VietHoang0605/OV7670_Camera_GitHub/Docs/REPORT_OV7670_CAMERA_FINAL.html

📚 Lý Thuyết & Kiến Trúc 🐛 Nhật Ký Sửa Lỗi

# BÁO CÁO KỸ THUẬT TOÀN DIỆN: DỰ ÁN HỆ THỐNG CAMERA OV7670 TRÊN FPGA

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

💡 GHI CHÚ QUAN TRỌNG: Báo cáo này tổng hợp lại toàn bộ kiến trúc hệ thống, lý thuyết cốt lõi về chuẩn I2C, giao thức DVP, bộ đệm Ping-Pong SDRAM và đặc biệt là Nhật ký Debug 5 Chặng Sinh Tử để đưa hệ thống từ chỗ màn hình nhiễu rác đến khi xuất ra hình ảnh thực tế hoàn hảo.

# I. TỔNG QUAN KIẾN TRÚC HỆ THỐNG

# 🗺️ SƠ ĐỒ KHỐI HỆ THỐNG TOÀN DIỆN (FULL SYSTEM TOPOLOGY)

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

## Chú thích luồng hệ thống:

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

## MÔ HÌNH TRỪU TƯỢNG HÓA LUỒNG DỮ LIỆU (DATA FLOW)

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

### 1. Trạm đóng gói kẹo 16-gram (Mô hình DVP Capture)

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

1. W-FIFO (Bồn chứa trung chuyển đầu nguồn): Camera giống như một con suối tự nhiên, dòng chảy (PCLK) không đều đặn và có những lúc ngắt quãng (Blanking). W-FIFO chính là một Bồn chứa nước nhỏ đặt ngay dưới thác nước. Khối DVP Capture liên tục hứng từng giọt nước từ Camera đổ vào bồn này. Mục đích của bồn W-FIFO là gom đủ một lượng nước nhất định (ví dụ: 256 giọt) để chuẩn bị cho một lần xả lớn, tránh việc phải vận chuyển từng giọt một cách lắt nhắt gây lãng phí băng thông bộ nhớ.
2. SDRAM (Hồ chứa thủy điện khổng lồ - Ping-Pong Bank): Đây là lõi của hệ thống. SDRAM giống như một Hồ chứa nước khổng lồ có khả năng chứa hàng triệu khối nước (đủ không gian cho toàn bộ khung hình 640x480). Tuy nhiên, để tránh việc nước sạch mới bơm vào bị lẫn lộn với nước cũ đang xả ra (gây hiện tượng xé hình ngang - Tearing), hồ chứa này được chia làm 2 nửa phân lô độc lập: Hồ A (Bank 0) và Hồ B (Bank 1).
3. Khi Hồ A đang mở cổng cho Camera đổ nước mới vào, thì Hồ B sẽ đóng cổng nạp và chỉ mở cổng xả để cấp nước cho VGA.
4. Khi cờ VSYNC phất lên (báo hiệu Camera đã vẽ xong 1 khung hình), chức năng của 2 hồ lập tức đảo ngược cho nhau (Ping-Pong). Hai luồng nước Đọc/Ghi sẽ không bao giờ giẫm chân lên nhau!
5. R-FIFO (Tháp nước áp lực cao khu dân cư): Màn hình VGA giống như một khu dân cư đông đúc. Khu dân cư này tiêu thụ nước liên tục với tốc độ cực kì khủng khiếp (25MHz) và tuyệt đối không chấp nhận việc bị ngắt quãng (nếu ngắt quãng, màn hình sẽ bị lệch pixel và nhiễu tĩnh ngay lập tức). Do đó, ta không thể nối ống trực tiếp từ Hồ SDRAM (vốn có độ trễ lớn và thỉnh thoảng phải dừng lại để tự sạc điện - Auto Refresh) đến khu dân cư được. R-FIFO chính là một Tháp nước áp lực cao đặt ngay sát khu dân cư VGA. Tháp nước này luôn được giữ ở mức đầy, đảm bảo áp lực nước xả xuống VGA luôn mạnh mẽ, trơn tru và liên tục không ngừng nghỉ.
6. SDRAM Arbiter (Người Gác Đập tẫn mẫn): Đây chính là bộ não điều phối (Finite State Machine - FSM) của toàn bộ hệ thống. Arbiter đóng vai trò là một Người Gác Đập tay cầm bộ đàm, đứng giữa Hồ khổng lồ (SDRAM) và hai đầu bồn chứa (W-FIFO, R-FIFO). Người Gác Đập gác đập tuân thủ một quy tắc sinh tử:
7. Người Gác Đập nhìn về phía Tháp nước R-FIFO. Tháp nước luôn được ưu tiên tuyệt đối. Hễ thấy Tháp nước vơi đi một nửa, Người Gác Đập lập tức bật siêu máy bơm, rút đúng 256 khối nước từ Hồ SDRAM bơm tốc hành lên Tháp (Burst Read) để cứu khát cho khu dân cư VGA.
8. Khi Tháp nước R-FIFO đã an toàn, Người Gác Đập mới quay sang nhìn Bồn trung chuyển W-FIFO. Nếu thấy bồn W-FIFO đã tích đủ 256 giọt nước từ suối Camera, Người Gác Đập sẽ mở van để hút trọn 256 giọt nước đó đổ vào Hồ SDRAM (Burst Write).
9. Nếu thiếu đi Người Gác Đập (hoặc Người Gác Đập bị treo máy do lỗi logic mất tín hiệu phao đo), Tháp nước R-FIFO sẽ cạn kiệt, VGA sẽ "chết khát" và màn hình sẽ ngay lập tức hiện đầy bùn đất (dữ liệu rác)!

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

# II. THIẾT KẾ KHỐI CẤU HÌNH I2C

# BÁO CÁO KIẾN TRÚC: LÕI GIAO TIẾP I2C (OVERSAMPLING 4X)

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

## 1. Bản chất Vật lý của I2C và Giới hạn Tần số

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

## 2. Bí kíp "Clock Enable" (Tick 4x) - Tại sao không dùng bộ chia Clock?

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

### Khối i2c_clk_gen (Nhạc trưởng)

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

### Khối i2c_master (Nhạc công)

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

## 3. Phân biệt "Đồng bộ (Synchronous)" và "Bất đồng bộ (Async CDC)"

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

# Nghệ thuật Thiết kế I2C Deep Dive

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

## 1. Cơ chế 4 Ticks của I2C: Tại sao phải chia làm 4 phách?

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

## 2. Nghệ thuật Clock Enable: Ảo giác tốc độ

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

## 3. Giao tiếp Handshake (Bắt tay): Mối tình giữa Config và Master

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

# III. LÝ THUYẾT DVP CAPTURE VÀ PING-PONG SDRAM

## 1. Bản chất của khối DVP Capture

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

## 1. Kiến trúc tổng thể và Giải phẫu tín hiệu DVP chi tiết

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

💡 GHI CHÚ QUAN TRỌNG: Góc Nhìn Lịch Sử & Bản Chất Vật Lý: Tại sao lại có Vùng Đen (Blanking)?

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

## 2. Nghệ thuật ghép ảnh RGB565: Bức Tranh 16-bit Từ Mảnh Ghép 8-bit

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

## 3. Cầu nối Async FIFO: Vượt Qua Khoảng Cách Không Gian - Thời Gian (Clock Domain)

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

⚠️ CẢNH BÁO:

## ⚠️ LUẬT THÉP: CẠM BẪY DỄ SAI VÀ LƯU Ý SỐNG CÒN

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

# IV. NHẬT KÝ SỬA LỖI (BUG HUNTING & DEBUGGING)

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

## 1. Hình ảnh hiện tượng

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

## 2. Nguyên nhân gốc rễ (Lỗi Logic Trọng tài & Khởi động Camera)

Dự án gặp phải 2 vấn đề nghiêm trọng chạy song song:

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

## 3. Mô hình Trừu tượng (Mạng Lưới Bơm Nước)

Hãy tưởng tượng hệ thống FPGA của hệ thống là một mạng lưới cấp nước:

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

## 4. Tại sao lại đem fifo_sync trở lại?

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

## 1. Hình ảnh thực tế chặng 2

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

### Bằng chứng code gốc trong sdram_controller.v:

Tại dòng 134-135 của file gốc Project 2:

// Mode: CAS=3, Read=Full Page, Write=Single Access (Bit 9 = 1)
sdram_addr <= 12'h237;

Và tại dòng 203-204:

WRITE_DATA: begin
    // Write là Single Access

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

### Bảng so sánh tương quan tốc độ giữa 2 Project:

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

## 3. Phân tích 2 câu hỏi kỹ thuật của Sếp

### Câu hỏi 1: Tại sao chỉ bơm được ~1/3 màn hình?

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

### Câu hỏi 2: Tại sao hình ảnh lại bị nhiễu sọc ngang rất nặng?

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

## 4. BẢN ĐỒ SỬA CHỮA HỆ THỐNG (SYSTEM REPAIR BLUEPRINT)

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

### Chi tiết các bước thực hiện:

1. Module rptr_empty.v & async_fifo.v:
2. Xây dựng mạch giải mã Gray-to-Binary để chuyển rq2_wptr thành nhị phân.
3. Tính toán rcount = wptr_bin - rbin_reg (mực nước khả dụng của W-FIFO ở miền 50MHz).
4. Xuất cổng output wire [10:0] rcount.
5. Module sdram_controller.v:
6. Cấu hình lại Mode Register: Đổi 12'h237 (Single Write) $\rightarrow$ 12'h037 (Full Page / Programmed Burst Write).
7. Thiết kế trạng thái WRITE_STREAM: Bơm liên tục 256 pixel trong 256 nhịp xung nhịp (chỉ mất $5,12\,\mu\text{s}$ cho một khối 256 pixel thay vì $51,2\,\mu\text{s}$ như trước).
8. Module sdram_arbiter.v:
9. Thay đổi điều kiện ghi: Không ghi nhắt gừng từng pixel khi !w_fifo_empty nữa, mà chờ w_fifo_count >= 256 mới kích hoạt 1 Burst Ghi.
10. Tăng địa chỉ theo khối: write_addr <= write_addr + 256.
11. Module ov7670_top.v:
12. Nối chân rcount từ u_w_fifo sang w_fifo_count của u_sdram_arbiter.

## CHẶNG 3: SỰ CỐ "BÁC GÁC ĐẬP NHÂN BẢN NƯỚC" VÀ "DÒNG SUỐI HOA MẮT"

## 1. Hiện tượng tại Khu dân cư (Màn hình VGA)

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

## 2. Bắt bệnh Hệ thống (Nguyên nhân lỗi)

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

## 3. Bản đồ Sửa chữa (Cách Fix)

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

## 1. Đặt vấn đề

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

## 2. Phương pháp tiếp cận (Thu hẹp phạm vi - Tối quan trọng)

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

## 3. Phân tích căn nguyên (Root Cause Analysis - Điểm nhấn suy luận)

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

## 4. Giải pháp khắc phục

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

### Chi tiết mã nguồn (Module ov7670_top.v):

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

Tác giả: Kỹ sư Phát triển Hệ thống FPGA (Portfolio Case Study)

## 1. Điểm khởi đầu đánh lừa (The Illusion of Simplicity)

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

## 2. Vòng lặp tuyệt vọng và Sự phản bội của Mô phỏng

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

## 3. Bước ngoặt tư duy (The Paradigm Shift) và Bằng chứng "Color Bar"

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

## 4. SignalTap II - Ánh sáng soi chiếu "Hộp đen" Tầng Vật lý

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

## 5. Bắt quả tang kẻ thù (The Missing Pull-up)

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

## 6. Giải pháp Tầng Điện tử và Cú chốt hạ lịch sử

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

cl set_instance_assignment -name WEAK_PULL_UP_RESISTOR ON -to cam_sda set_instance_assignment -name WEAK_PULL_UP_RESISTOR ON -to cam_scl

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

## 7. Khóa chặt quang học và Chinh phục nhiễu dây dẫn (Signal Integrity)

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

## 8. Bài học đắt giá cho một Kỹ sư Hệ thống

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

## 1. Mô tả Hiện tượng (The Symptom)

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

Hình ảnh thực tế lỗi 5 sọc dọc: Lỗi 5 Sọc Dọc

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

## 2. Quá trình Cô lập và Thu hẹp Phạm vi (The Isolation Process)

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

### Bước 1: Test "Màn Hình Đỏ" (Khẳng định VGA Timing)

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

### Bước 2: Bơm Dữ Liệu Ảo vào R-FIFO (Giải oan cho Khối Đọc Cuối)

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

### Bước 3: Bơm Dữ Liệu Ảo vào W-FIFO (Lật Mặt Kẻ Thủ Ác)

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

## 4. Cú Lừa Của Giai Đoạn "Write Burst" (The Misdirection)

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

## 5. Chân Tướng Sự Thật: Lỗ Hổng CAS Latency

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

Tuy nhiên, đoạn code cũ lại được viết như sau:

    // Chờ CAS=3 (T3 data mới tới)
    if(delay_timer == 16'd2) begin
        current_state <= READ_STREAM;

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

## 6. The Fix - Lát Cắt Lịch Sử

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

Đã sửa thành:

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
