VietHoang0605/OV7670_Camera_GitHub/SYSTEM_BLOCK_DIAGRAM_COLORED.png

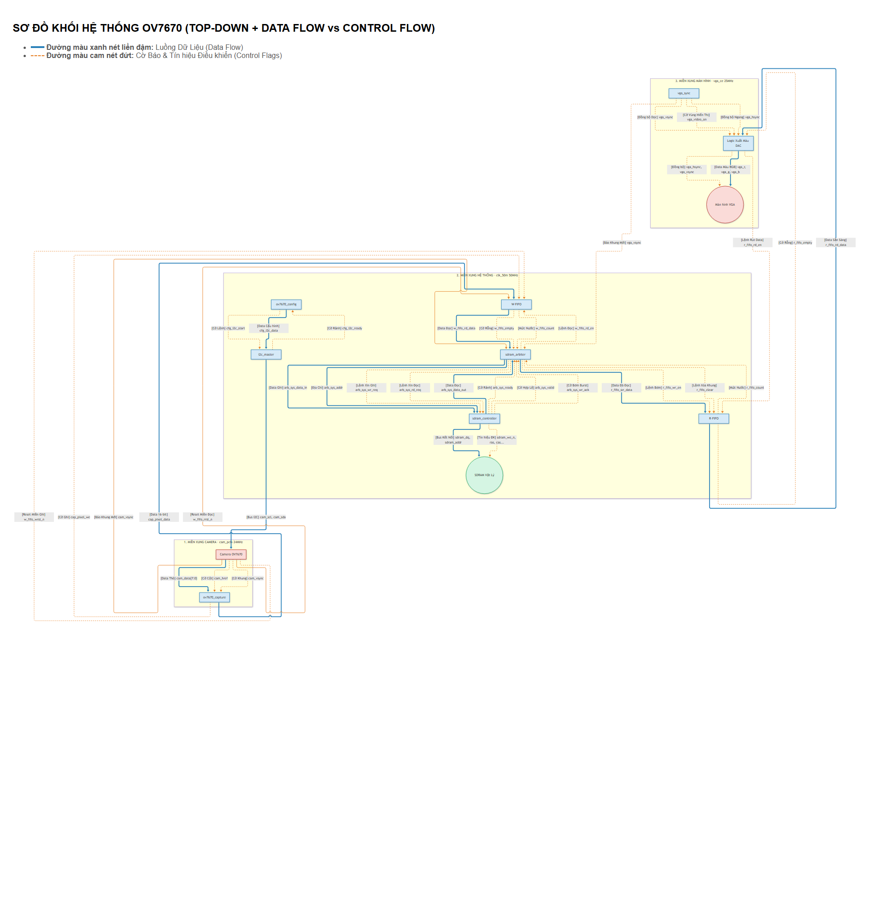
SYSTEM_BLOCK_DIAGRAM_COLORED.png
