VietHoang0605/OV7670_Camera_GitHub/Web_Deployment/assets/FSM_SDRAM_ARBITER.png

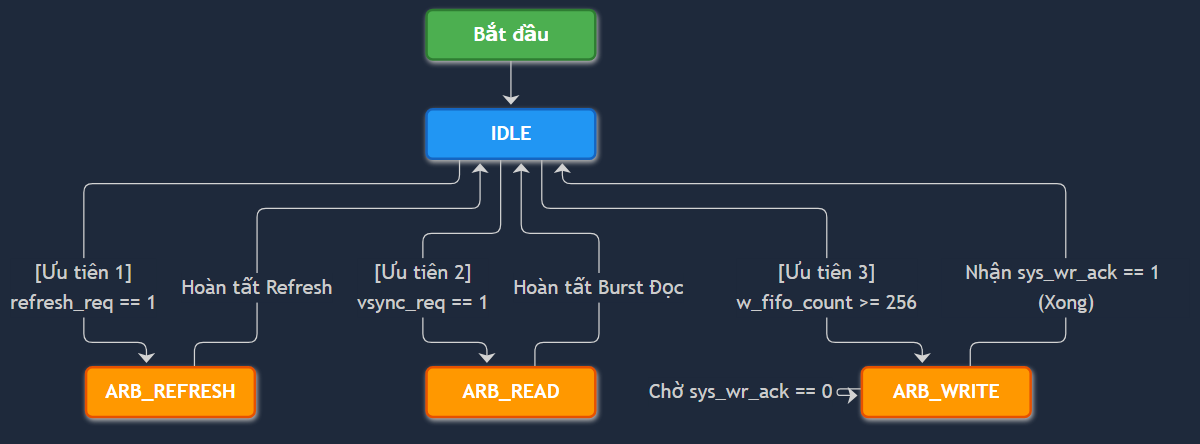
Web_Deployment/assets/FSM_SDRAM_ARBITER.png
