VietHoang0605/OV7670_Camera_GitHub/Web_Deployment/assets/media_1789984404120.jpg

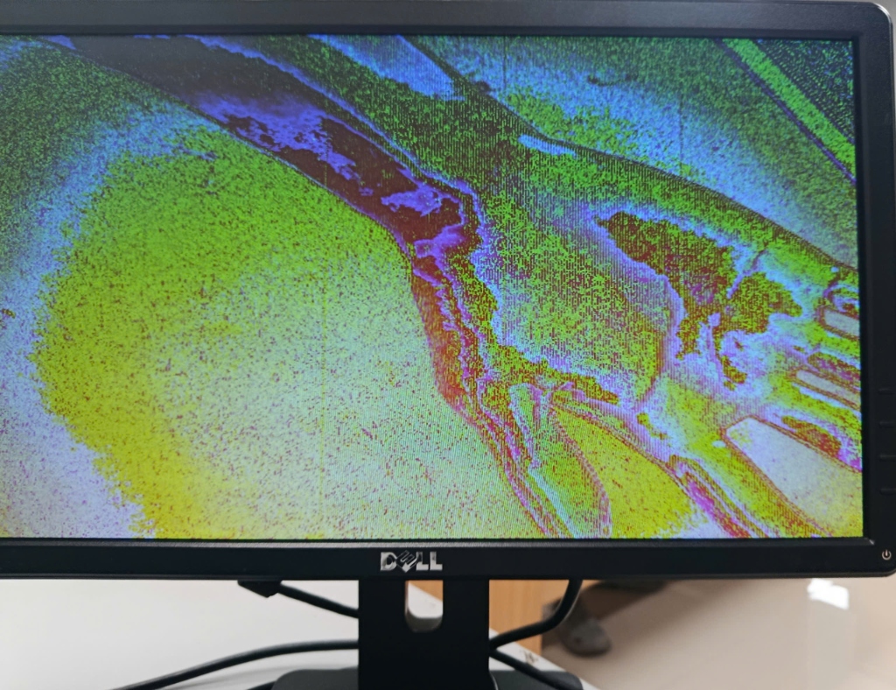
Web_Deployment/assets/media_1789984404120.jpg
