VietHoang0605/OV7670_Camera_GitHub/Web_Deployment/assets/media_1790416947117.png

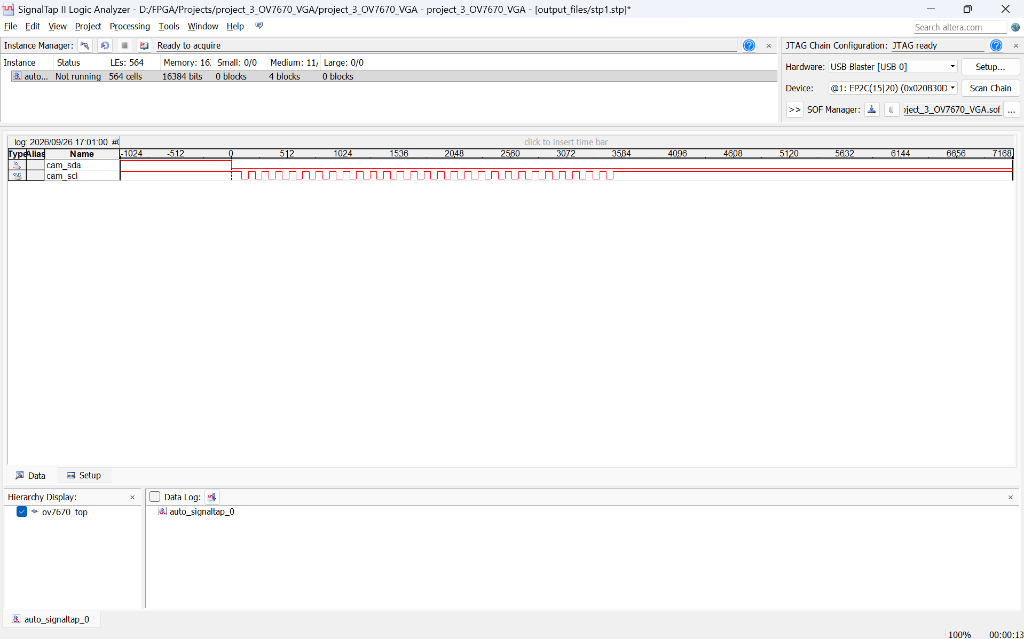
Web_Deployment/assets/media_1790416947117.png
