VietHoang0605/OV7670_Camera_GitHub/Docs/PHASE_4_BUG_HUNTING_REPORT.md

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

**Tác giả:** Kỹ sư Phát triển Hệ thống FPGA (Portfolio Case Study)

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

## 2. Vòng lặp tuyệt vọng và Sự phản bội của Mô phỏng
Để sửa dải màu, tôi đã tiến hành thay đổi và thử nghiệm vô vàn các tập lệnh cấu hình I2C/SCCB khác nhau. Nhưng bất chấp mọi nỗ lực, màu sắc trên màn hình vẫn không hề suy xuyển.

Với tư duy cô lập hệ thống, tôi đã tạo hẳn một môi trường mô phỏng chuyên sâu (`sim_debug_color`) để rà soát từng dòng code. Kết quả mô phỏng (Waveform trên ModelSim) trả về **hoàn hảo 100%**. Mọi module hoạt động đúng nhịp, dữ liệu trích xuất chính xác. Thế nhưng, khi nạp xuống mạch thật, hình ảnh vẫn giữ nguyên màu sắc hỏng hóc.

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

## 3. Bước ngoặt tư duy (The Paradigm Shift) và Bằng chứng "Color Bar"
Đứng trước mớ bòng bong, tôi quyết định lùi lại một bước và đưa ra một giả thuyết táo bạo: **Cái sọc dọc và trôi hình không phải do module code của chúng ta có vấn đề!**
Để chứng minh điều đó, tôi đã sử dụng phương án "Color Bar": Ép Camera xuất ra dải màu thử nghiệm nội bộ thông qua duy nhất 1 lệnh `COM7 = 0x06`. 

**Tại sao Color Bar lại là bằng chứng ngoại phạm hoàn hảo cho RTL?** 
Chế độ Color Bar là một bộ tạo ảnh nhân tạo tích hợp sẵn bên trong lõi DSP của OV7670, bỏ qua hoàn toàn mắt kính quang học để xuất ra một dải 8 màu sọc dọc hoàn hảo (Trắng, Vàng, Cyan, Lục, Magenta, Đỏ, Lam, Đen). Nếu màn hình VGA hiện lên được dải màu này một cách mượt mà, tĩnh lặng, không trôi, không xé... thì điều đó chứng minh tuyệt đối 100% rằng luồng dữ liệu (Data Pipeline) từ `ov7670_capture -> W-FIFO -> SDRAM Arbiter -> R-FIFO -> VGA` của tôi được thiết kế hoàn hảo.

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

## 4. SignalTap II - Ánh sáng soi chiếu "Hộp đen" Tầng Vật lý
Để điều tra I2C, ban đầu tôi đã gán các cờ báo vào hệ thống đèn LED của DE1:
* `LED[9]` nối vào cờ `config_done` của module `ov7670_config.v` để xem FSM có đếm hết 156 lệnh hay không.
* `LED[8]` nối vào biến `ack_error` (qua một mạch chốt latch) của module `i2c_master.v` để bắt lỗi từ chối lệnh.

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

Đó là lúc tôi rút ra vũ khí tối thượng: **SignalTap II Logic Analyzer**. Khác với Waveform lý tưởng hóa của ModelSim, SignalTap cấy trực tiếp vào lõi Silicon để bắt tín hiệu điện áp thực.

**Phân tích kỹ thuật trên SignalTap:**
Để bắt được tín hiệu, tôi đã thiết lập Trigger theo đúng định nghĩa tín hiệu START của giao thức I2C: **SDA tụt từ 1 xuống 0 trong khi SCL vẫn đang giữ ở mức 1**. Khi SignalTap bắt được đúng khoảnh khắc này, nó khẳng định Module Master của tôi đã bắt đầu chu trình truyền tải thành công. 

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

## 5. Bắt quả tang kẻ thù (The Missing Pull-up)
Khi giăng bẫy SignalTap để đo chân `cam_sda` và `cam_scl`, tôi đã bắt được quả tang một hiện tượng không thể tin nổi:

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

Như bạn có thể thấy ở bức ảnh trên: Ngay sau khi lệnh START được phát ra, tín hiệu SDA tụt xuống mức logic 0 và **nằm lì ở đó trong suốt toàn bộ chu kỳ truyền**, mặc dù SCL vẫn đập liên tục.

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

## 6. Giải pháp Tầng Điện tử và Cú chốt hạ lịch sử
Để khắc phục sự thiếu sót của phần cứng, tôi đã ép FPGA phải tự xuất điện trở nội bộ thông qua lệnh cấu hình QSF: `set_instance_assignment -name WEAK_PULL_UP_RESISTOR ON`.
Nhưng 40k Ohm nội bộ là quá yếu để kéo cáp lên mức 1 kịp thời ở tốc độ 400kHz. Lập luận từ góc độ điện tử tương tự (Analog), tôi đã chủ động hạ xung nhịp I2C xuống **100kHz** để cho tín hiệu có đủ thời gian (Rise time) sạc đầy lên 3.3V.

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

## 7. Khóa chặt quang học và Chinh phục nhiễu dây dẫn (Signal Integrity)
Mặc dù I2C đã hoạt động, nhưng khi ép xuất Color Bar, hình ảnh vẫn còn hiện tượng giằng co với quang học thực tế và chớp nháy (Flickering) liên tục. Để đạt được sự hoàn hảo tuyệt đối, tôi đã tung ra 2 đòn đánh cuối cùng:

**Đòn 1: Combo lệnh phong ấn quang học (I2C)**
Tôi cấu hình lại bộ lệnh I2C để cô lập hoàn toàn mạch DSP nội bộ khỏi cảm biến quang:
* `COM17 = 0x08`, `SCALING_XSC = 0xBA`, `SCALING_YSC = 0xB5`: Ép các khối thu phóng và xử lý số kích hoạt Test Pattern.
* `COM8 = 0xC0`: Tắt hoàn toàn bộ phơi sáng (AEC), khuếch đại (AGC) và cân bằng trắng (AWB) để camera ngừng "tẩu hỏa nhập ma" khi bị bịt mắt.
Lúc này, cờ `ack_error` (LED 8) đã tắt lịm, chứng minh combo lệnh khó nhằn trên lọt 100% vào trong camera.

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

## 8. Bài học đắt giá cho một Kỹ sư Hệ thống
Chặng 4 là một bài test tâm lý và kỹ năng cực độ. Nó chứng minh rằng:
1. **Kiến thức liên ngành là sức mạnh:** Một kỹ sư thiết kế Digital (RTL) sẽ kẹt ở đây mãi mãi nếu không có nền tảng về Điện tử Tương tự (Sự xả nạp RC, Open-Drain, Pull-up, Signal Integrity).
2. **Luôn nghi ngờ Hộp đen vật lý:** Đèn LED và Simulation chỉ chứng minh thiết kế logic của bạn đúng, chứ không chứng minh mạch điện vật lý của bạn đang sống. 
3. **Kỹ năng gỡ lỗi là nghệ thuật đặt câu hỏi:** Khi bị lạc giữa muôn trùng bug, việc quay về lệnh đơn giản nhất (Color Bar) và soi chiếu tín hiệu vật lý cơ bản (SignalTap) chính là la bàn dẫn đến thành công.
