VietHoang0605/OV7670_Camera_GitHub/(commit log)

2026-09-28 Cập nhật comment code và báo cáo điện trở nội
    cập nhật comment cho file code ov7670_config và báo cáo về điện trở nội ở chặng 4-nhật kí sửa lỗi
2026-09-28 cập nhật báo cáo điện trở nội
    nằm ở nhật kí sửa lỗi_chặng 4_mục 6
2026-09-28 fix: Bổ sung các file ảnh/video bị thiếu cho bộ giả lập VGA
2026-09-30 docs: Cập nhật nội dung mục 7 (Signal Integrity & Output Registering)
2026-09-30 fix(UI): Cập nhật mô tả chính xác cho các chặng giả lập (Simulator)
2026-10-01 fix(UI): Xoá từ 'sếp' còn sót lại trong tiêu đề phân tích chặng 2
2026-10-01 docs: Cập nhật phân tích luồng dữ liệu (Data Flow) ở Chặng 2
2026-10-01 docs: Cấu trúc lại phần chi tiết các bước thực hiện và bổ sung sơ đồ Mermaid FSM
2026-10-01 fix(UI): Chuyển đổi sơ đồ FSM sang định dạng ảnh SVG tương tác giống hệ thống khối gốc
2026-10-01 docs: Nhúng Sơ đồ Mermaid số 1 (Luồng Dữ liệu Burst Write) vào báo cáo Chặng 2
2026-10-01 fix(UI): Sửa lỗi Syntax Mermaid FSM, khôi phục tương tác Lightbox và làm đẹp sơ đồ
2026-10-01 fix(UI): Xóa bỏ sơ đồ lỗi số 1 và bọc dấu ngoặc kép cho text để sửa Syntax Error sơ đồ FSM
2026-10-01 fix(UI): Sửa lỗi cú pháp Mermaid triệt để bằng cú pháp an toàn nhất
2026-10-01 fix(UI): Sử dụng cú pháp siêu an toàn cho sơ đồ FSM để loại bỏ hoàn toàn Syntax Error
2026-10-01 docs: Cập nhật tên miền mới trên Vercel cho báo cáo kỹ thuật
2026-10-01 fix(UI): Sửa lỗi cú pháp Mermaid do không hỗ trợ gộp linkStyle và khởi tạo Node
2026-10-01 fix(UI): Triệt tiêu lỗi Syntax Error do thuộc tính color không hợp lệ trong linkStyle của Mermaid
2026-10-01 chore: Dọn dẹp các file script test tạm thời
2026-10-01 fix(UI): Chuyển sơ đồ FSM sang chuẩn ảnh Vector SVG độc lập, đồng bộ 100% cơ chế Lightbox phóng to thu nhỏ với Sơ đồ khối
2026-10-01 fix(assets): Cập nhật file SVG FSM chuẩn màu sắc và tỷ lệ
2026-10-01 fix(UI): Khớp chuẩn chữ hoa chữ thường FSM_SDRAM_ARBITER.svg trên Linux Vercel
